MarcinezElectronics/BLOCK-Bike-Racks/README.md

# BLOCK-Bike-Racks
BLOCK Lupa Pilot Project - 10 Way Electric Lock
