MarcinezElectronics/BLOCK-Bike-Racks/10Way_Electric_Lock_21/Dokumentációk/BLOCK Lupa pilot teszt fejlesztés folyamatábra.pdf

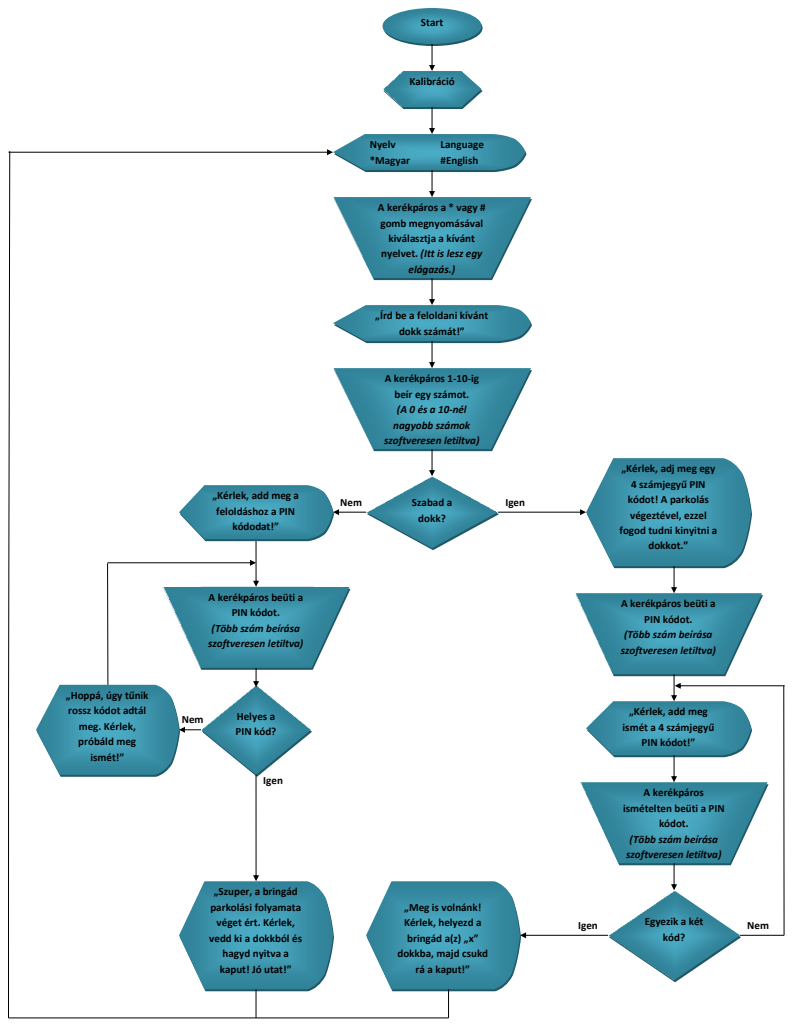
[picture p2: page 1]
Kalibráció; Start; Nyelv; Language; *Magyar; #English; Szabad a dokk?; Helyes a PIN kód?; Egyezik a két kód?; Nem; Igen

A kerékpáros a * vagy #
gomb megnyomásával
kiválasztja a kívánt
nyelvet. (Itt is lesz egy
elágazás.)

„Írd be a feloldani kívánt
dokk számát!”

A kerékpáros 1-10-ig
beír egy számot.
(A 0 és a 10-nél
nagyobb számok
szoftveresen letiltva)

„Kérlek, adj meg egy
4 számjegyű PIN
kódot! A parkolás
végeztével, ezzel
fogod tudni kinyitni a
dokkot.”

„Kérlek, add meg a
feloldáshoz a PIN
kódodat!”

A kerékpáros beüti a
PIN kódot.
(Több szám beírása

„Hoppá, úgy tűnik
rossz kódot adtál
meg. Kérlek,
próbáld meg
ismét!”

„Kérlek, add meg
ismét a 4 számjegyű
PIN kódot!”

A kerékpáros
ismételten beüti a PIN

kódot.

„Szuper, a bringád
parkolási folyamata
véget ért. Kérlek,
vedd ki a dokkból és
hagyd nyitva a
kaput! Jó utat!”

„Meg is volnánk!
Kérlek, helyezd a
bringád a(z) „x”
dokkba, majd csukd
rá a kaput!”

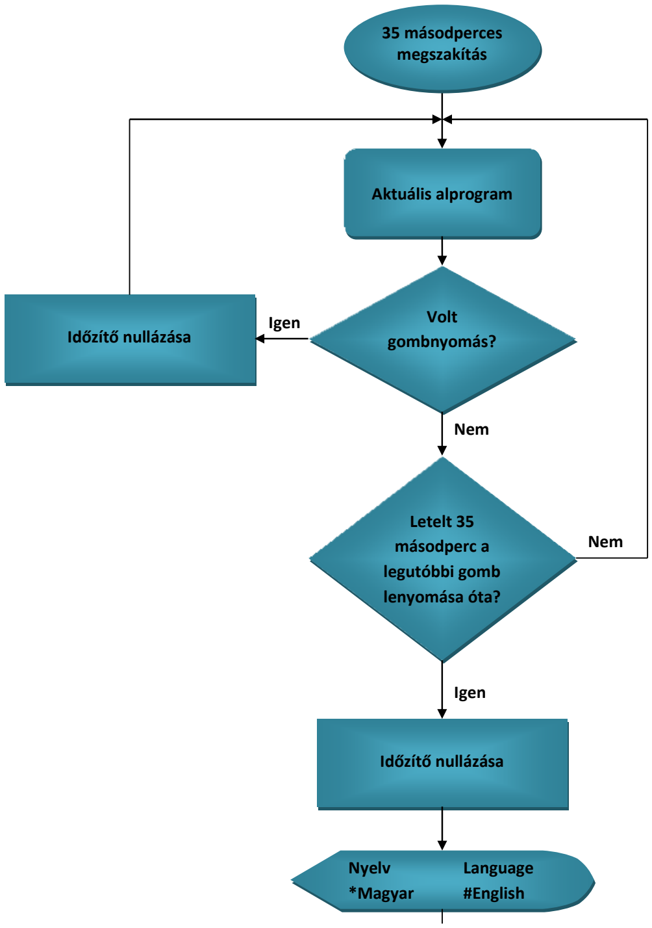
[picture p3: figure]
Aktuális alprogram; Letelt 35 másodperc a legutóbbi gomb lenyomása óta?; 35 másodperces megszakítás; Nyelv; Language; *Magyar; #English; Volt gombnyomás? Időzítő nullázása; Igen; Nem; Időzítő nullázása
