MarcinezElectronics/BLOCK-Bike-Racks/5_10Way_Electric_Lock_22/Elektromos rajzok/BikeLock_doboz_rajzok.pdf

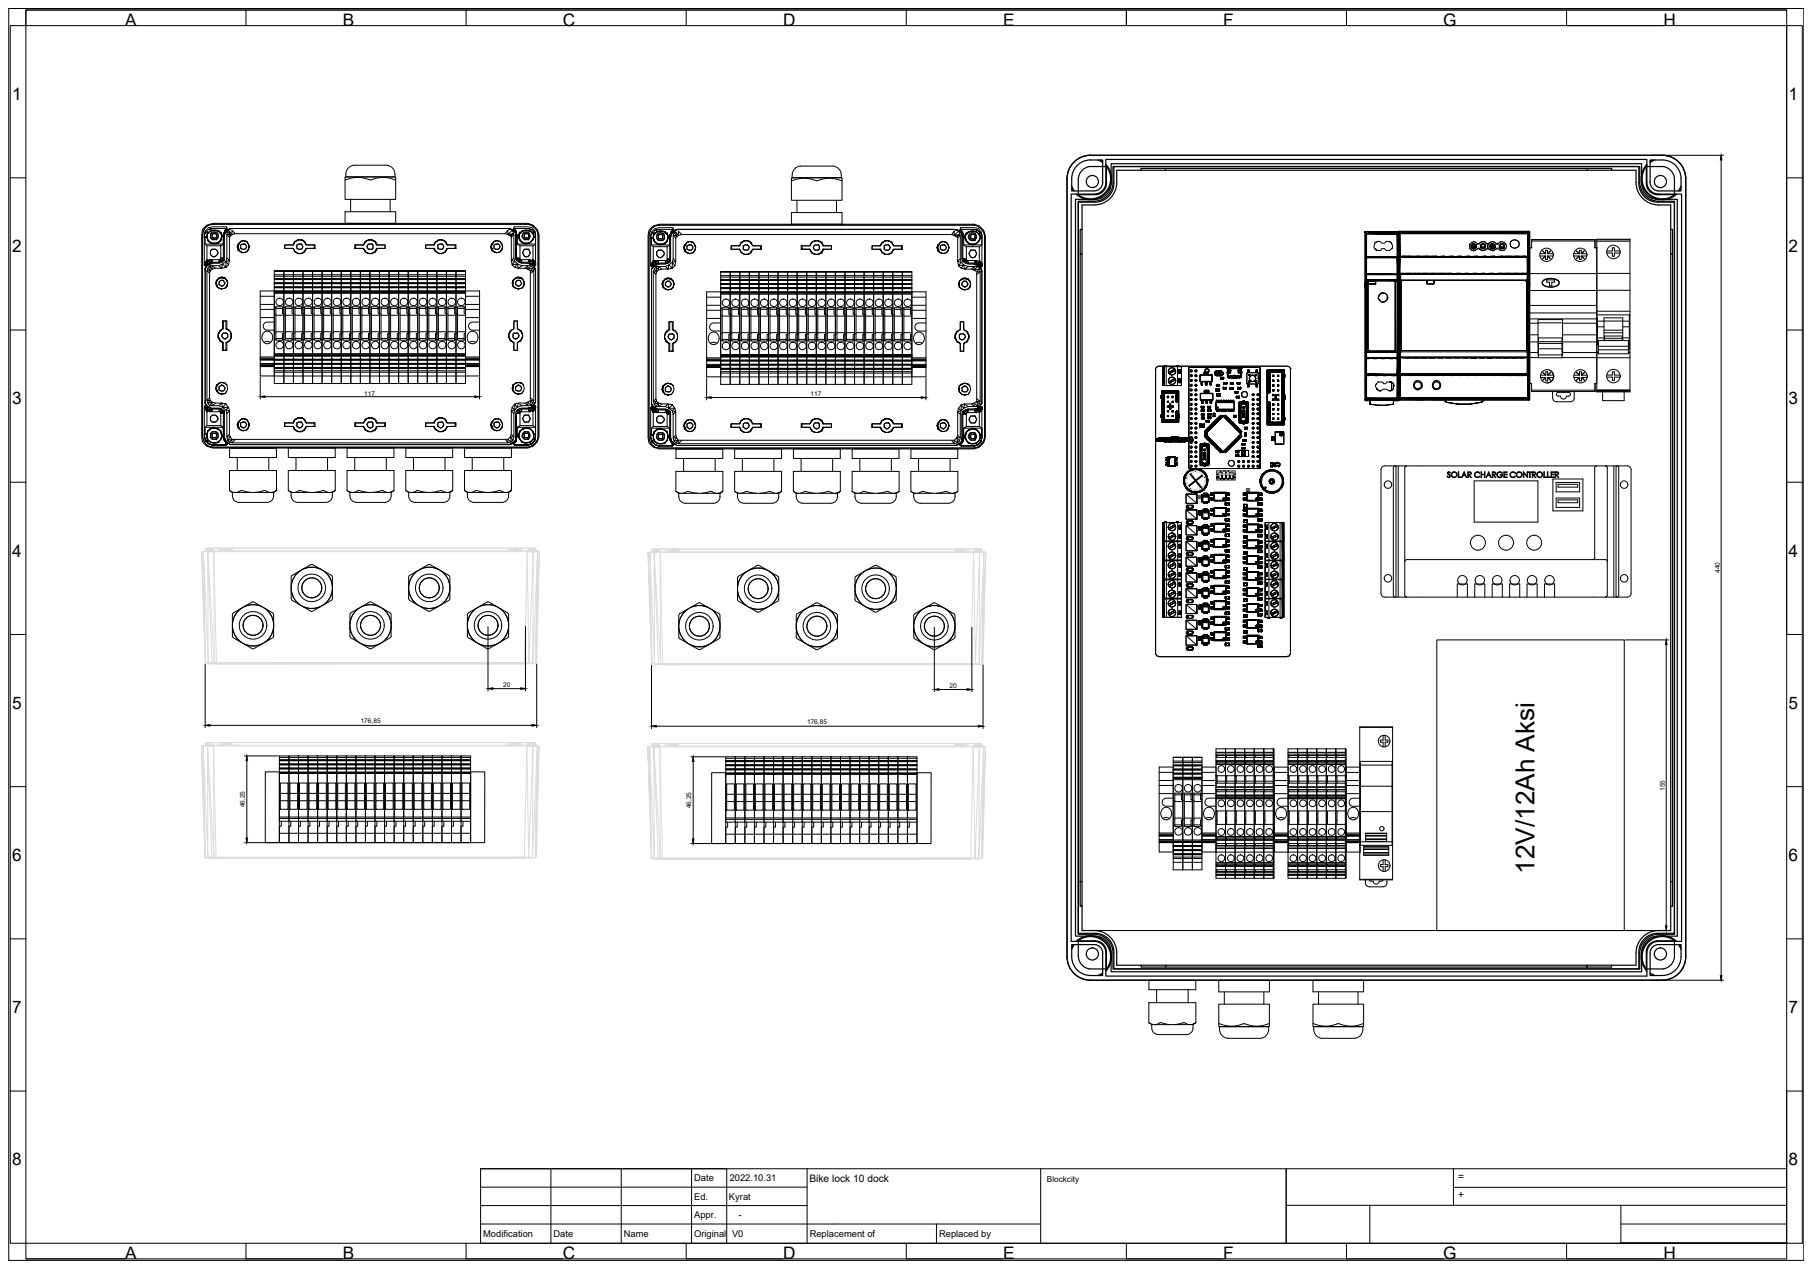
[picture p4: page 1]
12V/12Ah Aksi 155 440; + V0 Kyrat 2022.10.31; Replacement of; Replaced by; - Blockcity

Bike lock 10 dock
