MarcinezElectronics/BLOCK-Bike-Racks/5_10Way_Electric_Lock_22/Elektromos rajzok/BikeLock_Huzalozás.pdf

| | | | 2022. 10. 27. | BikeLock | KyMar | Legend
| | | Szerk. | KYRAT
| | | Ellenőrizve | | | | | Lap
Módosítás | Dátum | Név | eredetileg | | Kiegészítette | Pótolta | | | Tervlap
0 | 6 | 7
3 | 8 | 9

# Bike Lock Project

-2FI1
-2F1

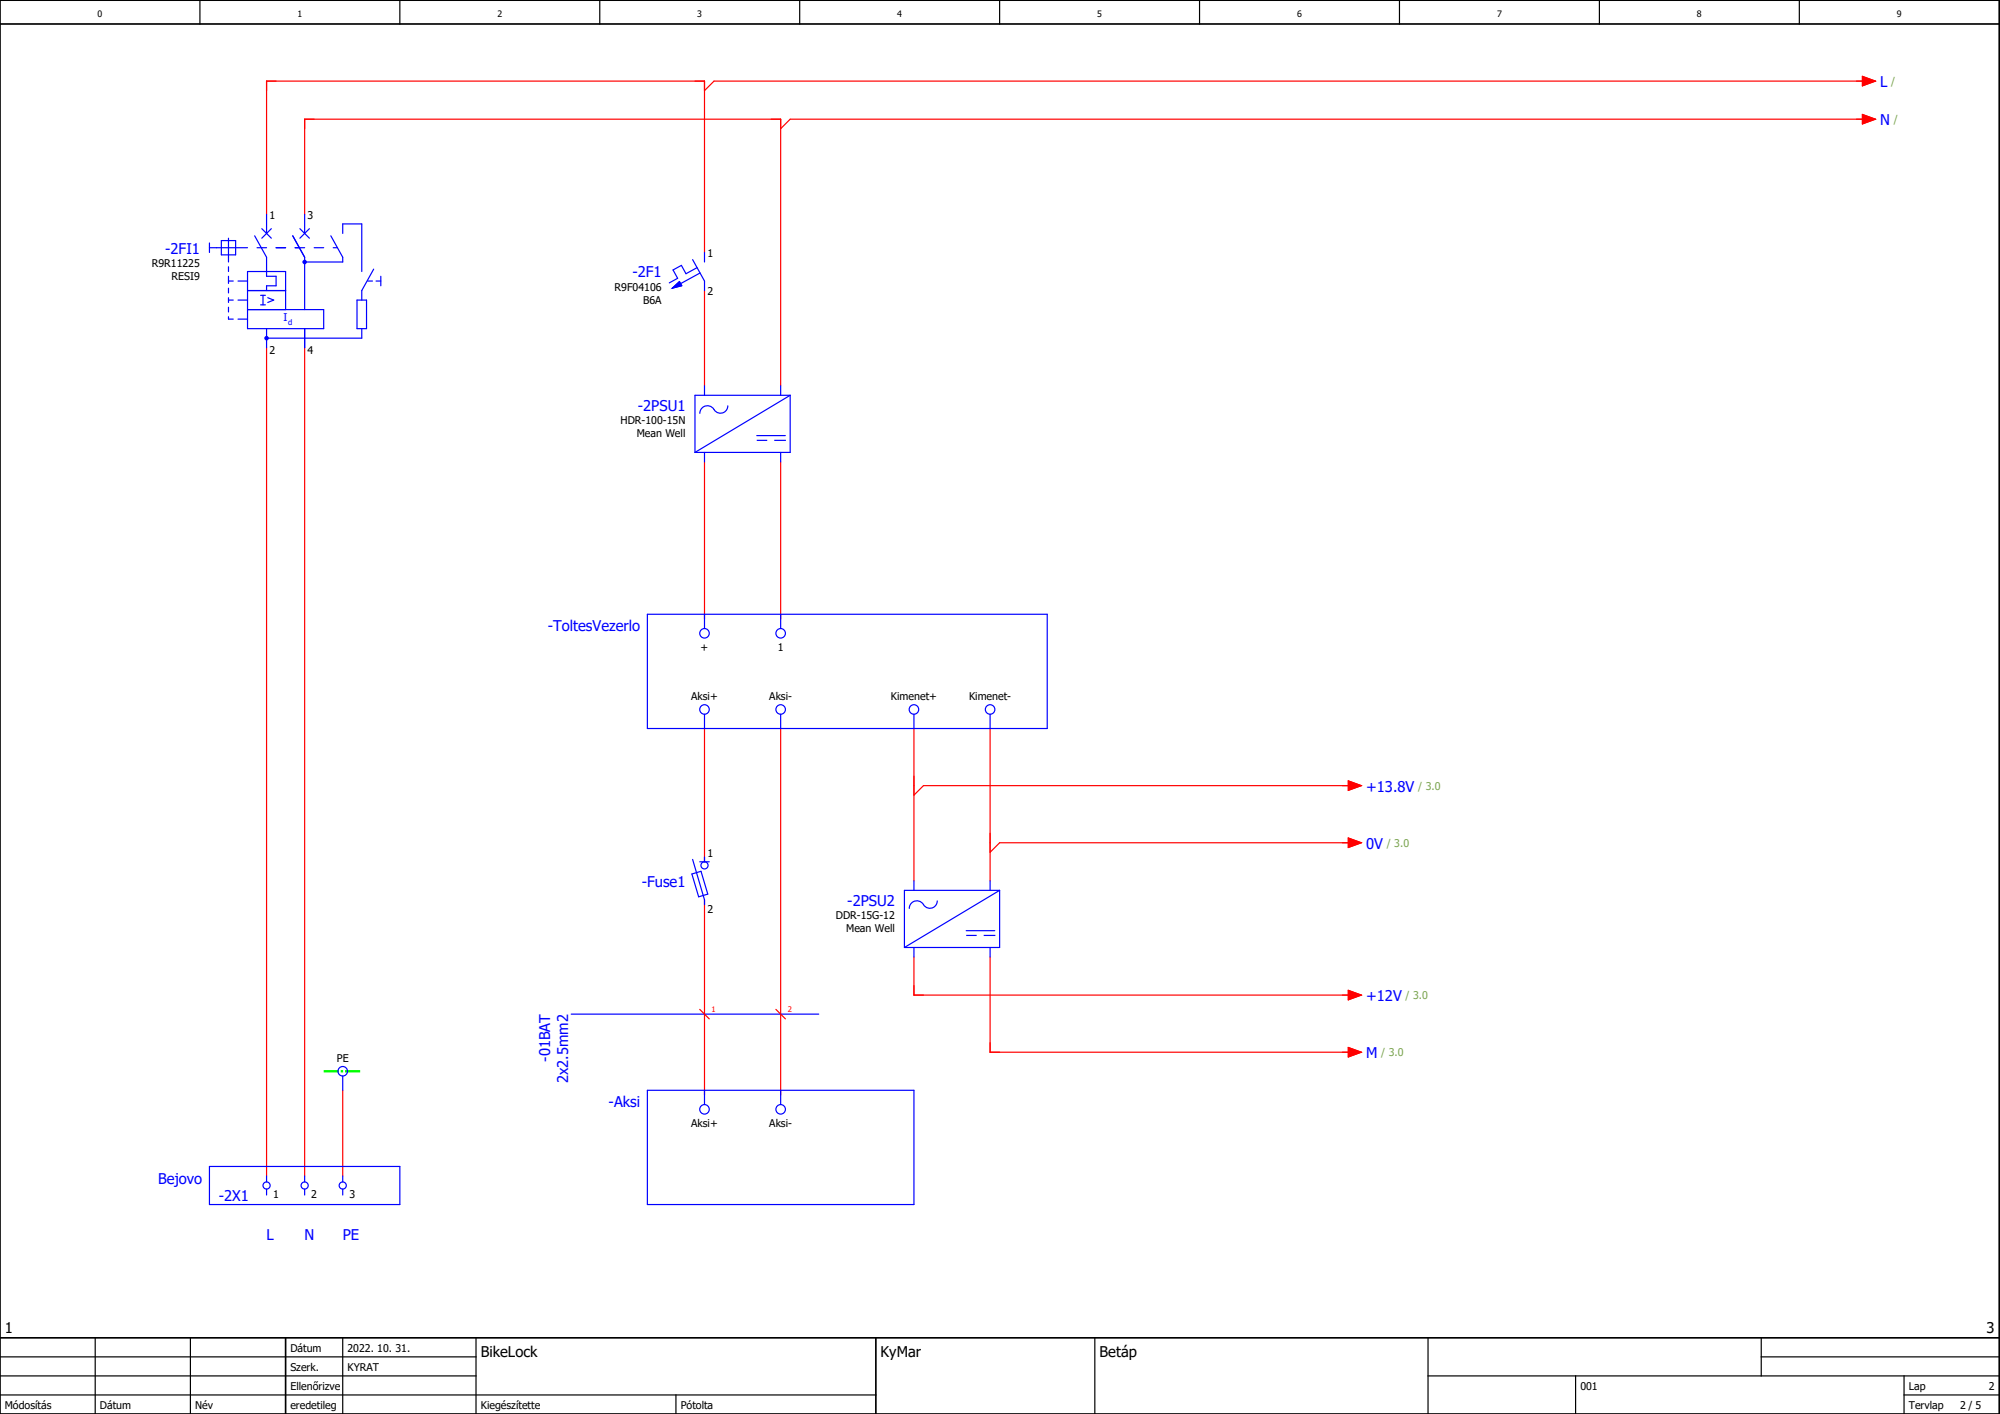
[picture p5: page 2]
Betáp; KyMar; Bejovo; R9R11225 RESI9; -2PSU1; HDR-100-15N Mean Well; -2PSU2; DDR-15G-12 Mean Well; -ToltesVezerlo; Aksi+; Aksi-; Kimenet+; Kimenet-; -Aksi; -Fuse1; -01BAT

# Betáp Induktív sz. Szolenoidok

9-12V

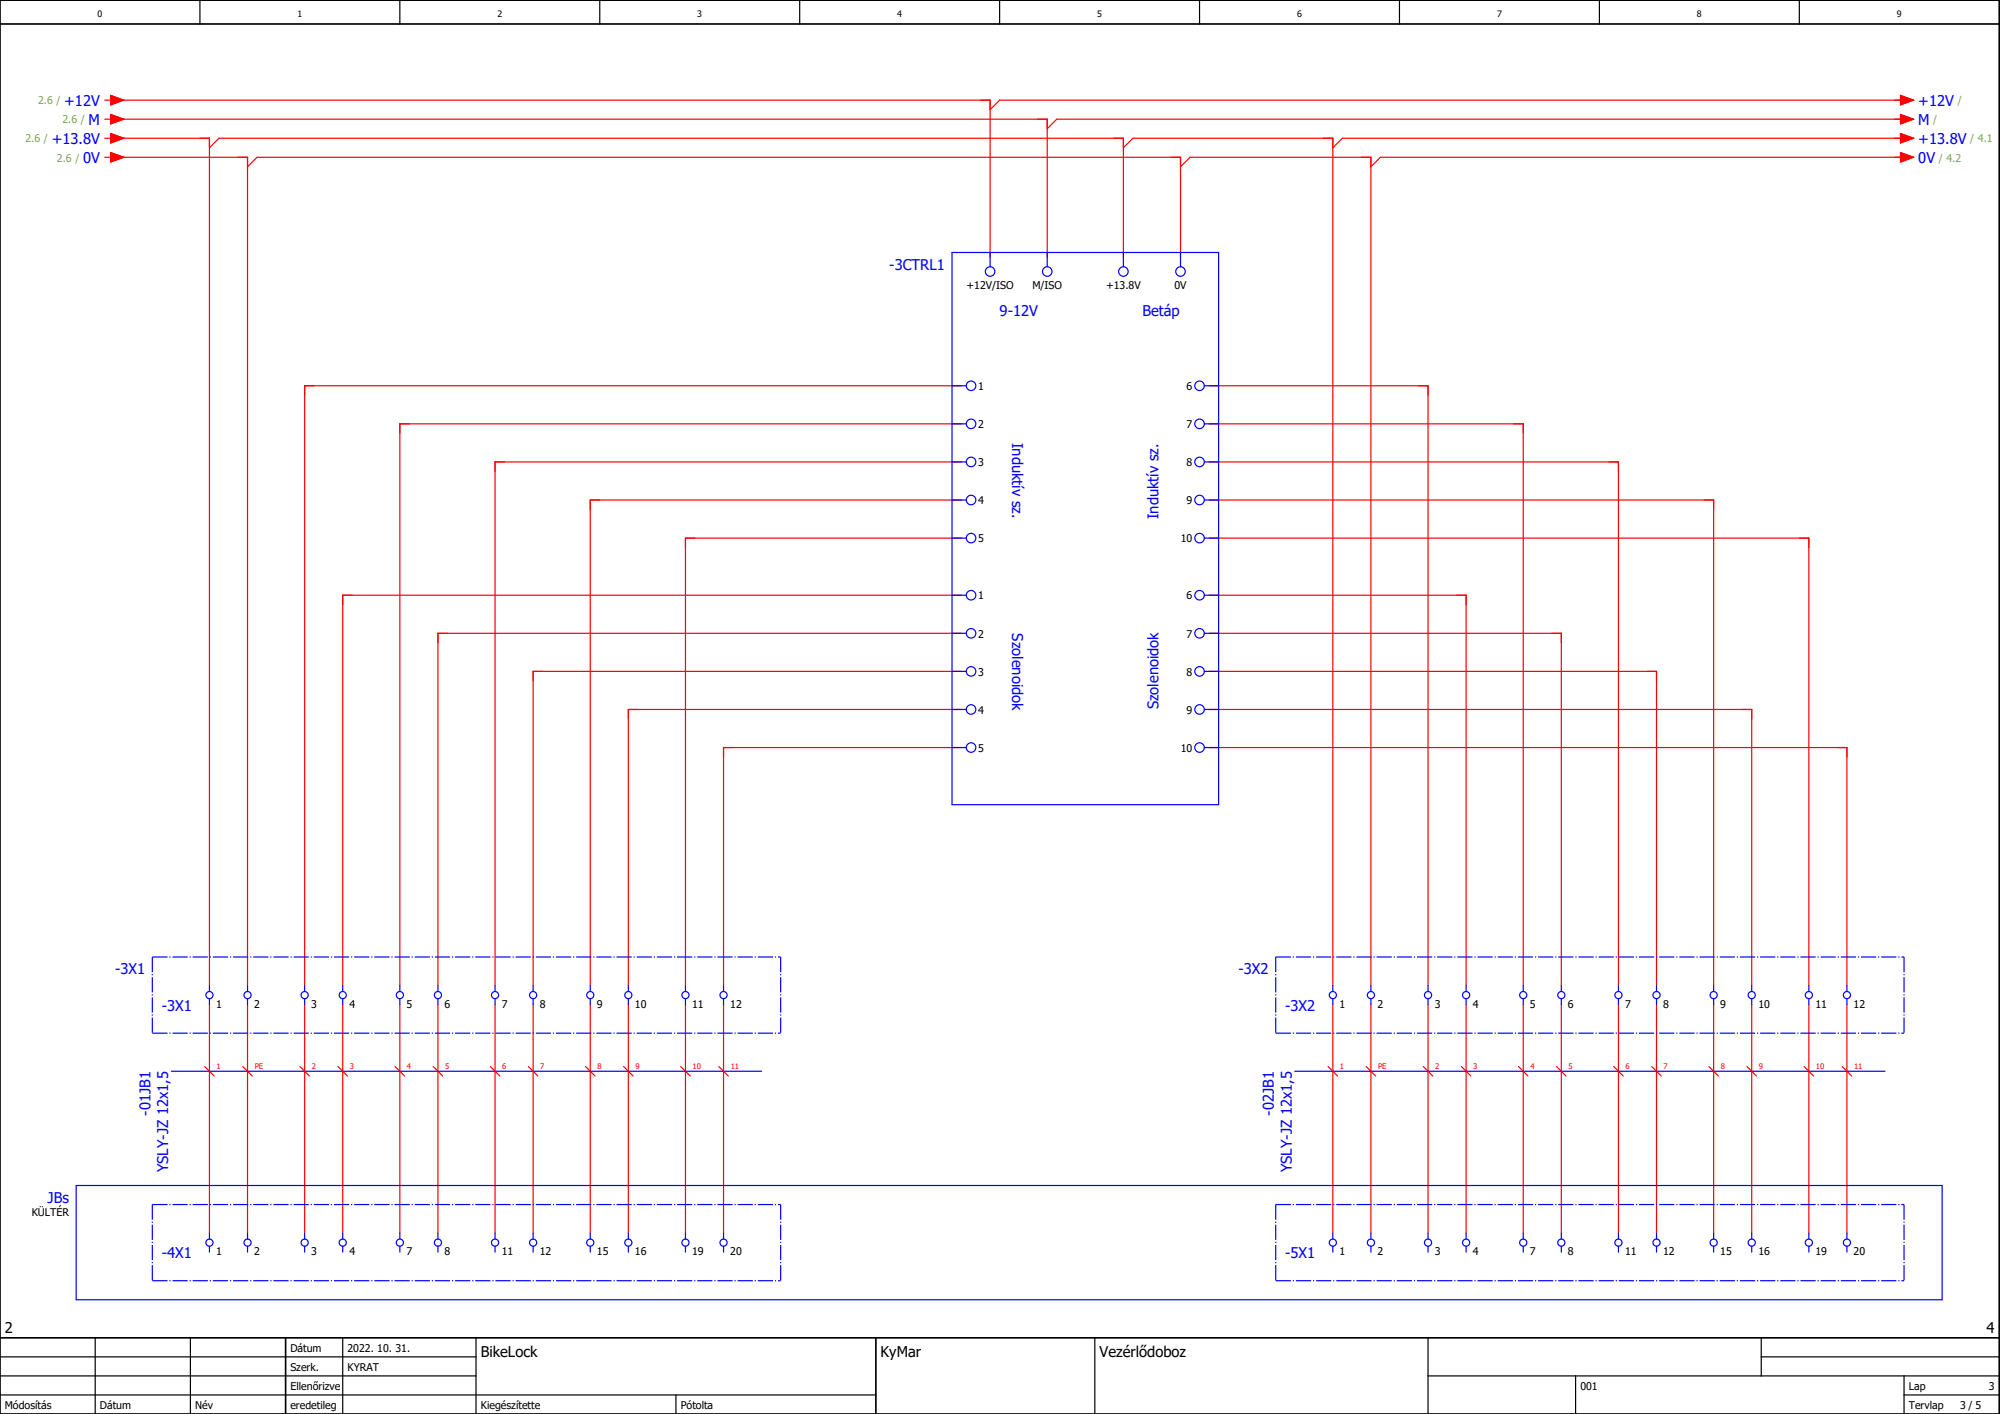
[picture p6: page 3]
Vezérlődoboz; -3CTRL1; +12V/ISO; M/ISO; JBs KÜLTÉR; YSLY-JZ 12x1,5

Induktív sz. Szolenoidok

+13.8V

0V

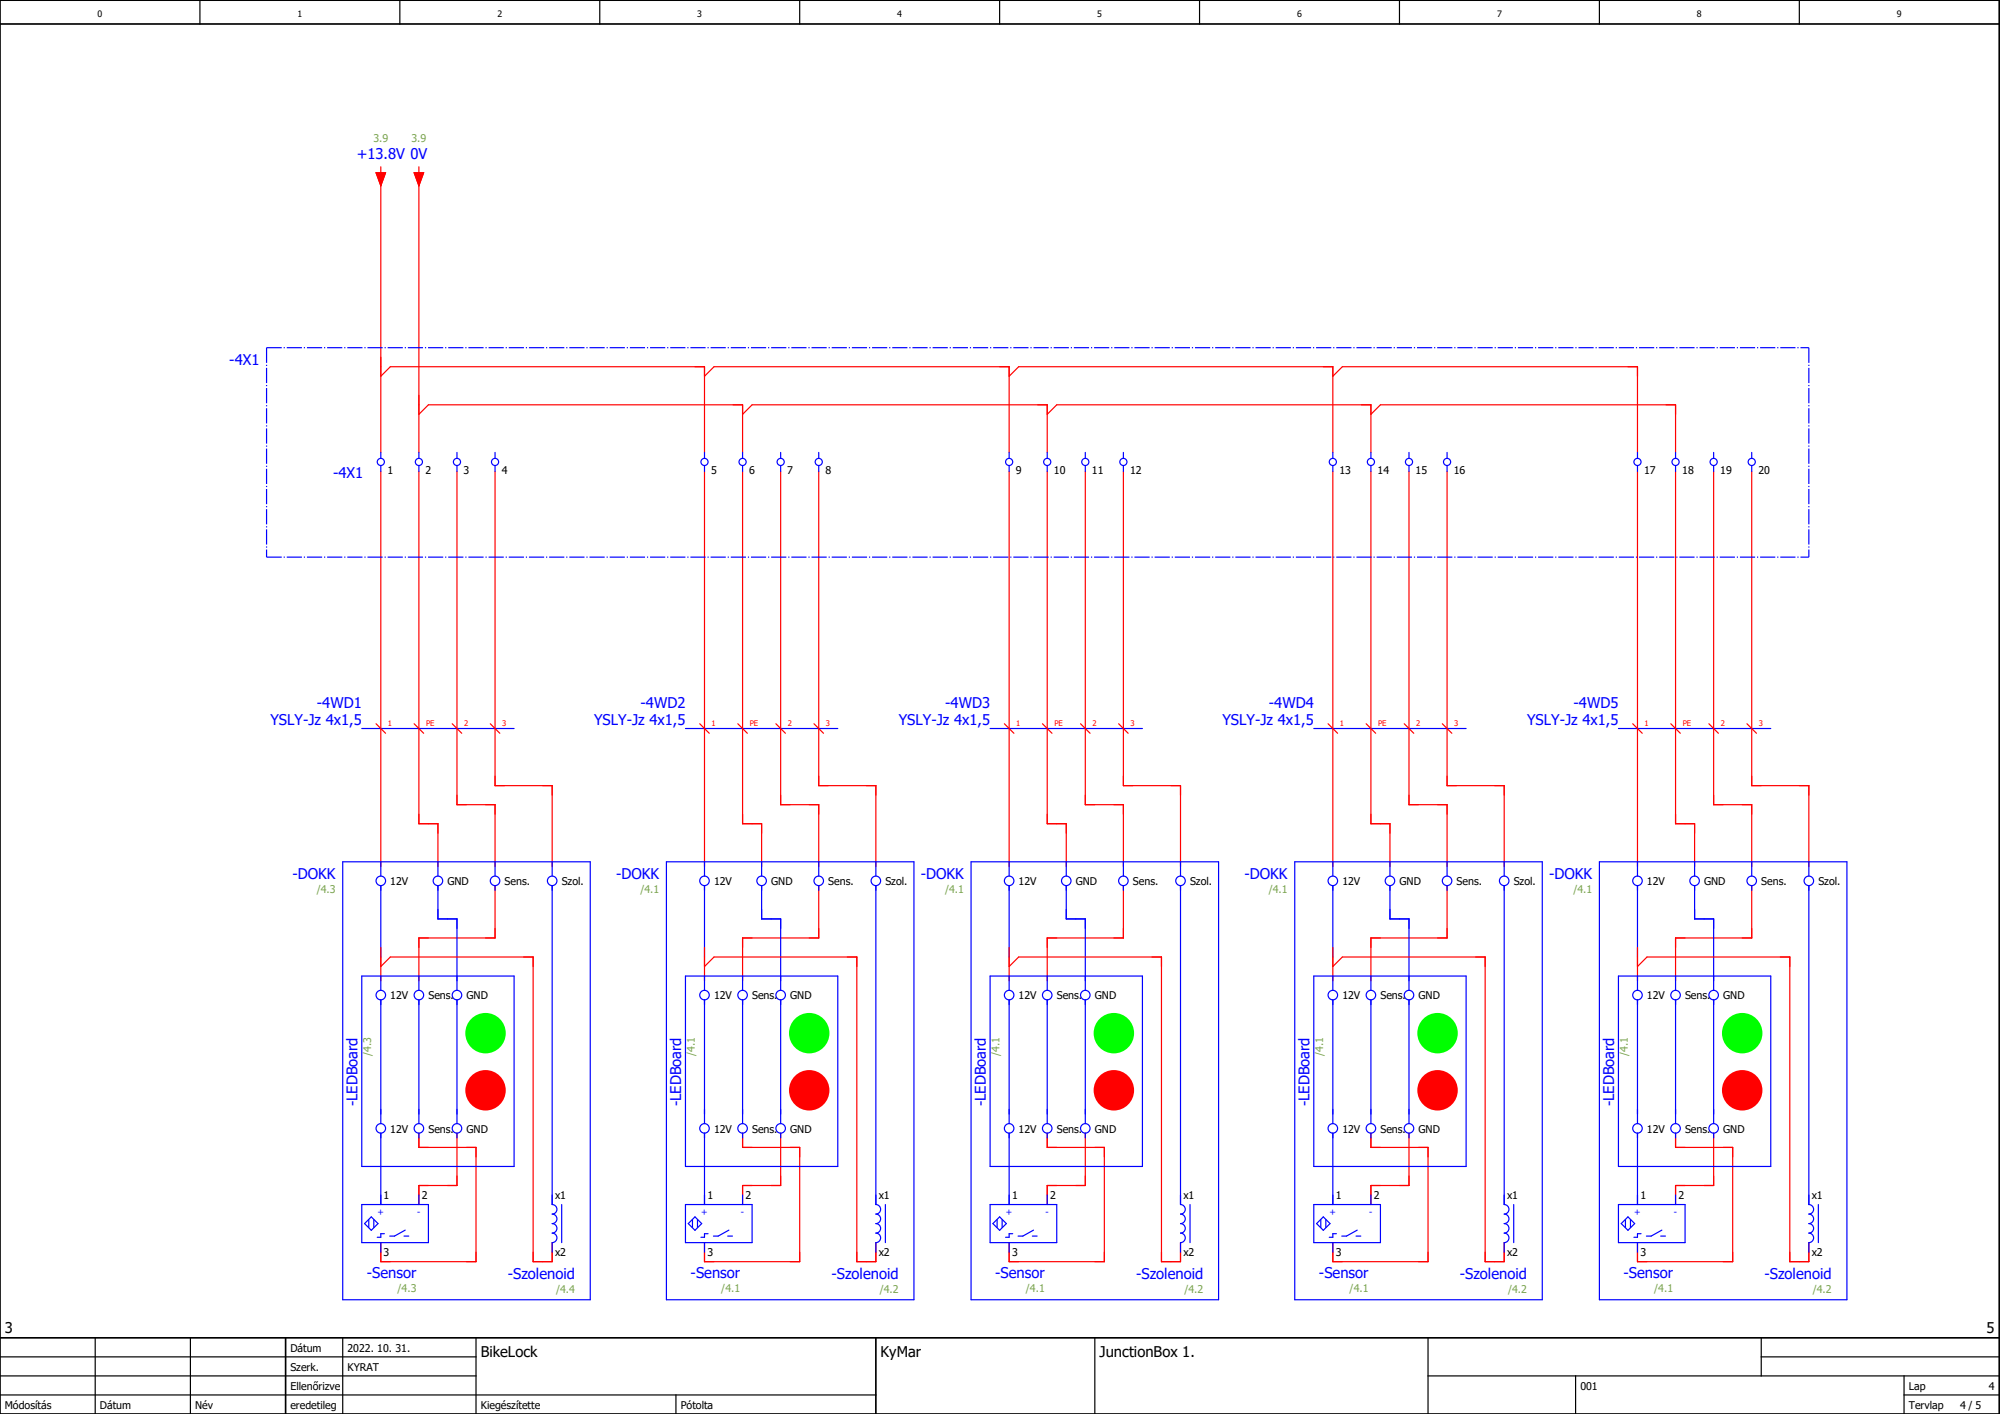
[picture p7: page 4]
JunctionBox 1.; -DOKK; YSLY-Jz 4x1,5; GND; Sens.; Szol.; -LEDBoard; -Sensor; -Szolenoid

+13.8V 0V

-5X1

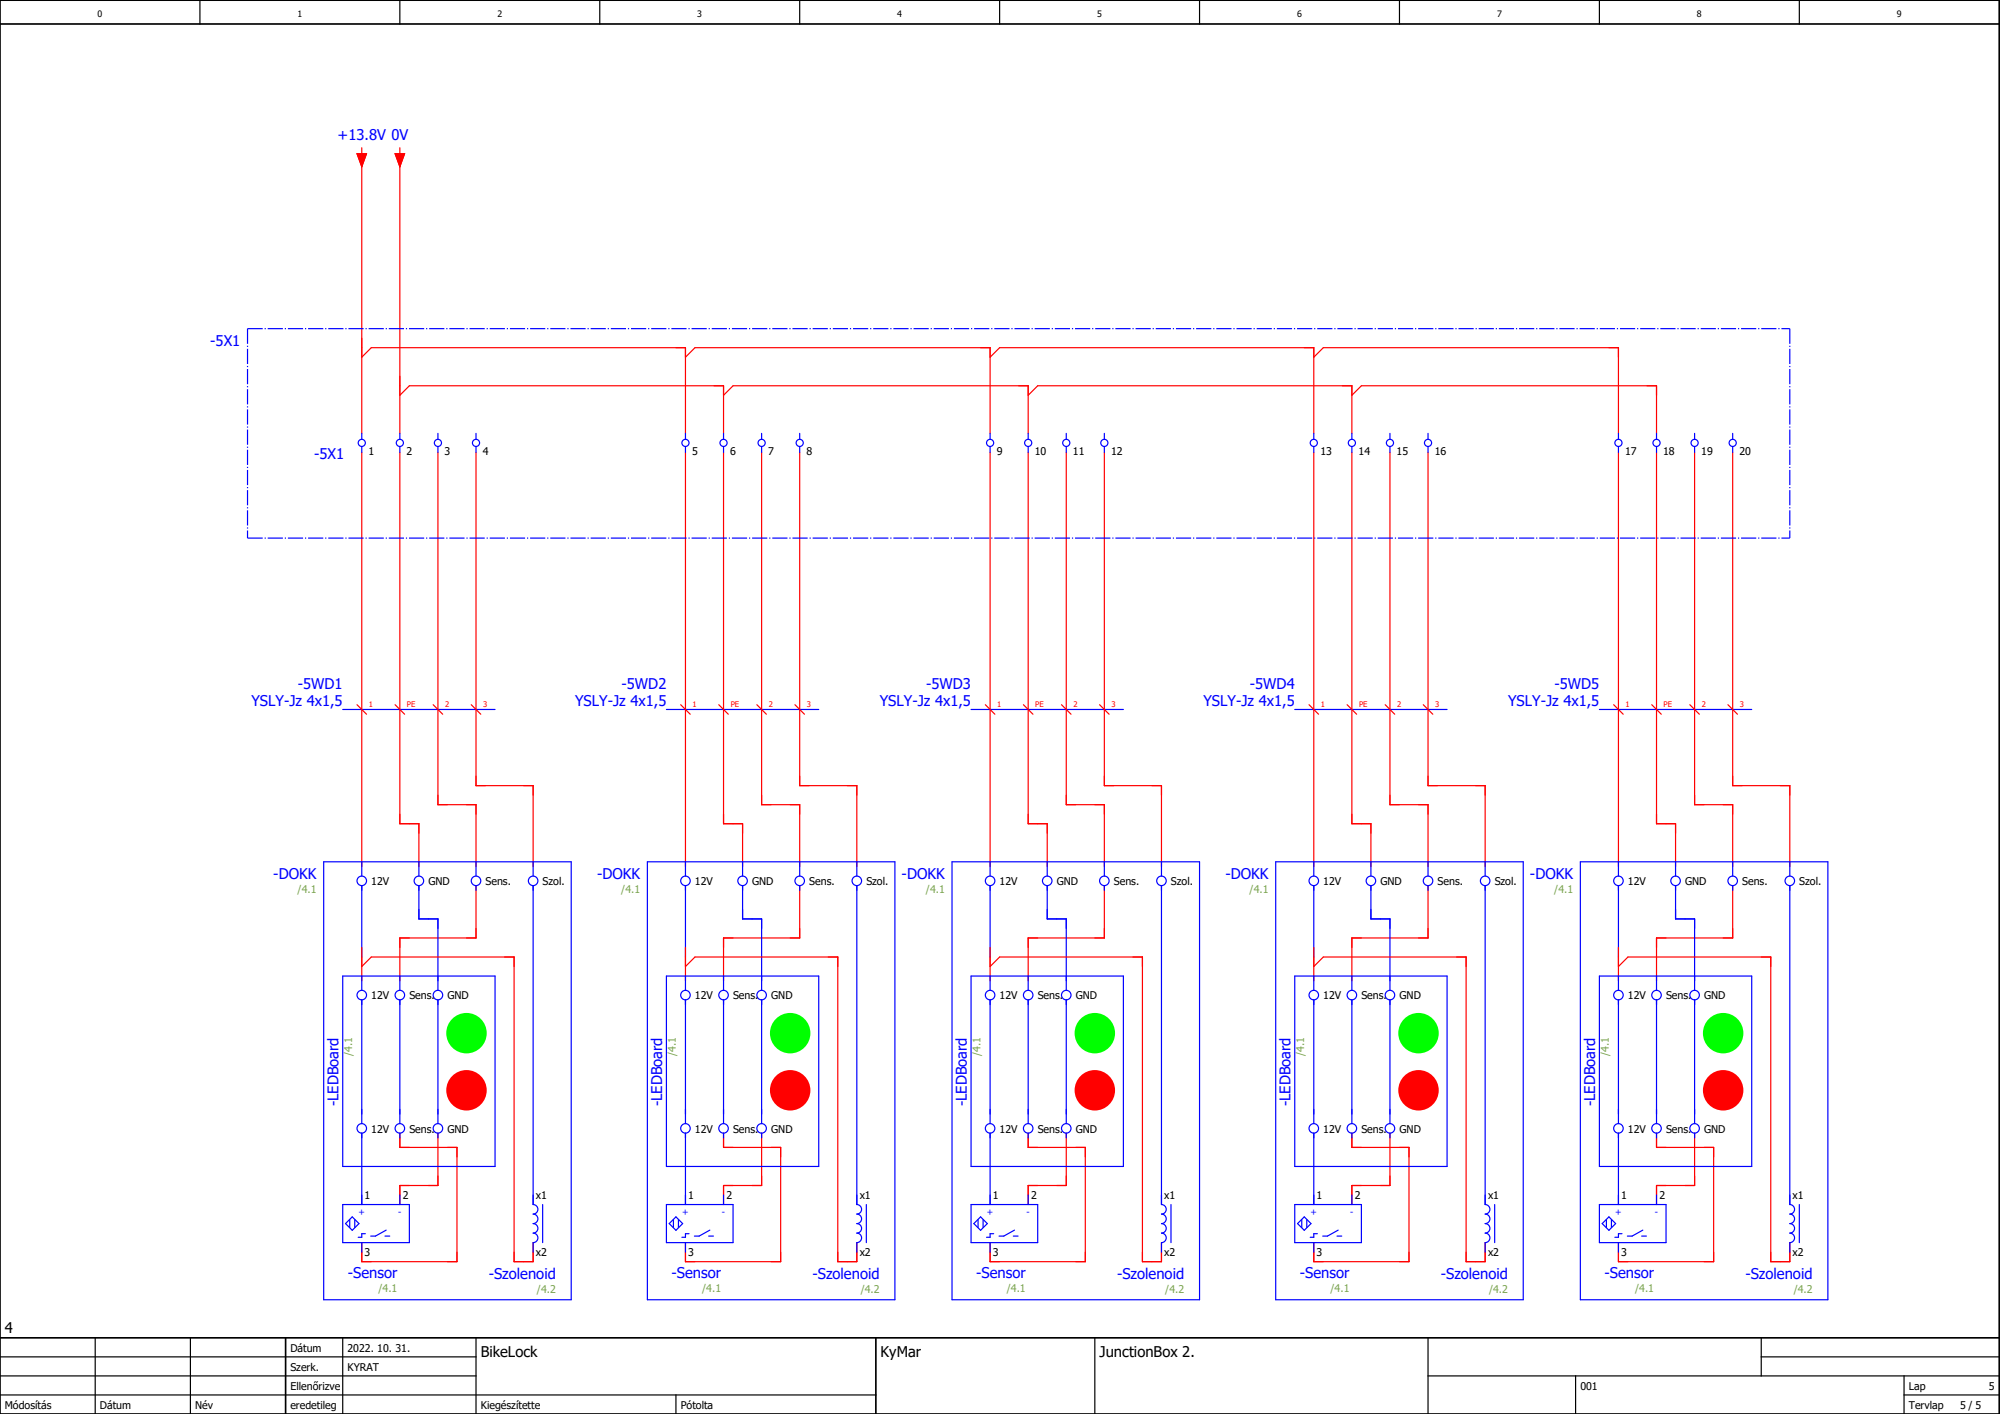
[picture p8: page 5]
JunctionBox 2.; YSLY-Jz 4x1,5; -DOKK; GND; Sens.; Szol.; -Szolenoid; -Sensor; -LEDBoard
