MarcinezElectronics/BLOCK-Bike-Racks/(list of files, drawings)

Other design files:
5_10Way_Electric_Lock_22/Kapcsolási rajzok/BlockBike_LED_Panel.dch
5_10Way_Electric_Lock_22/Kapcsolási rajzok/BlockBike_LED_Panel.dip
5_10Way_Electric_Lock_22/Kapcsolási rajzok/BlockBikeProject_22.dch
5_10Way_Electric_Lock_22/Kapcsolási rajzok/BlockBikeProject_22.dip
