MarcinezElectronics/BLOCK-Bike-Racks/(commit log)

2022-11-21 Design files are added.
    [BlockBikeProject_22.dch, BlockBikeProject_22.dip, BlockBike_LED_Panel.dch, BlockBike_LED_Panel.dip]
2022-11-21 Modified pin outs.
2022-11-23 Buzzer is added. Keypad is fixed.
    [10Way_Electric_Lock_22.ino]
2022-11-24 Problem CS1, CS2 is changed.
    [10Way_Electric_Lock_21.ino, 10Way_Electric_Lock_22.ino]
2022-12-04 10 way dock bug (L9-S0) is fixed.
    [10Way_Electric_Lock_22.ino, 10Way_Electric_Lock_22_5Dock.ino]
2022-12-05 Press button 1 double is going to admin menu.
2022-12-08 5/10 way firmware are able to define. Empty password bug is fixed.
    [BlockBikeProject_22.dch, BlockBikeProject_22.dip, BlockBike_LED_Panel.dch, BlockBike_LED_Panel.dip]
2022-12-09 Some bugs are fixed and firmware is tested.
    [5_10Way_Electric_Lock_22.ino]
2022-12-09 Sensor fault watching are added.
2022-12-13 8. dock logic is inverted.
    [5_10Way_Electric_Lock_22.ino]
